ChevFy/RobotCarArduino/Report Robot Car.pdf

## Report

# Robot Car Contest

### contributer

นายนันทพงศ์ พงศธ์ ำ | รงศกั ดิ์ | รหสั นักศกึษา 67011475
นายตณิ ณ์ | สงู เมฆ | รหสั นักศกึษา 67011448

### Introduction to Computer Engineering (ICE) Semester 1 Year 1 | Bachelor of Computer Engineering King Mongkut’s Institute of Technology Ladkrabang, KMITL

### Table of Content

แนวคดิ และหลกั การทำ | งานของ Robot Car | 2
การออกแบบ Hardware ของ Robot Car | 3
Circuit Diagram ของ Robot Car | 5
การออกแบบ Software Design ของ Robot Car | 6
Source Code ของ Robot Car | 10

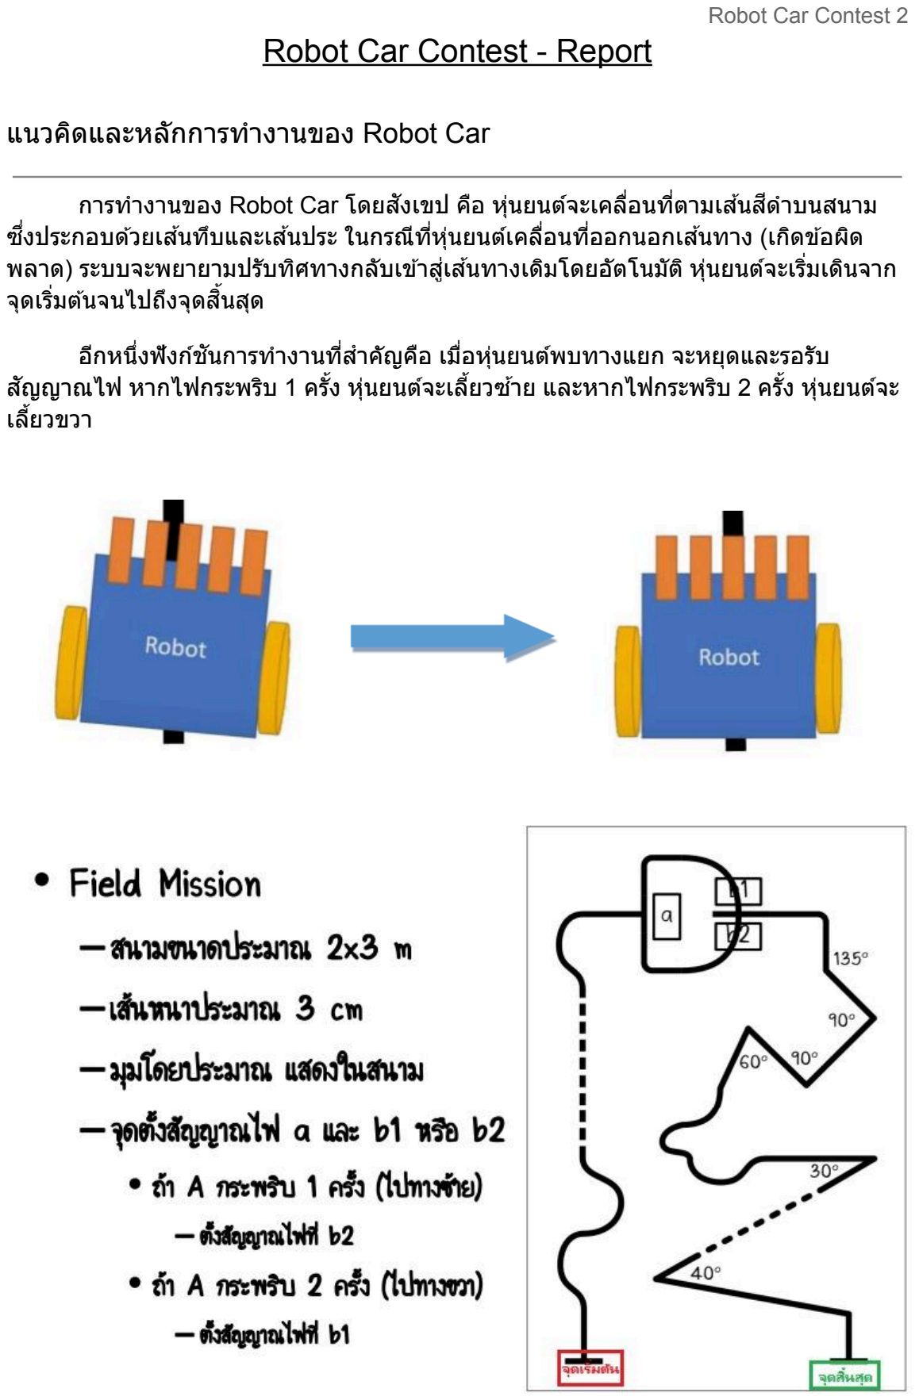
[picture p1: page 2]

Robot Car Contest 2

### Robot Car Contest - Report

แนวคดิ และหลกั การทำ | งานของ Robot Car
การทำ | งานของ Robot Car โดยสงเขป ั | คอื หนุ่ ยนตจะ์ เคลอนท ื่ | ตาม ี่ | เสน้ สดีำ | บนสนาม
ซงึ่ | ประกอบดวย้ เสน้ ทบึ และเสน้ประ ในกรณีทหี่ | นุ่ ยนตเคล ์ | อนท ื่ | ออก ี่ | นอกเสนทาง ้ | (เกดิขอ้ผดิ
พลาด) ระบบจะพยายามปรับทศทาง ิ | กลบั เขา้สเสู่ นทาง ้ | เดมิ โดยอตโนม ั | ตั ิหนุ่ ยนตจะ์ เรมิ่ | เดนิ จาก
จดุ เรมิ่ | ตน้ จนไปถงึจดุ สนสิ้ | ดุ
อกีหนงึ่ | ฟังกช์ นั การทำ | งานทสี่ | ำ | คญั คอื เมอื่ | หนุ่ ยนตพบ์ ทางแยก จะหยดุ และรอรับ
สญญาณ ั | ไฟ หากไฟกระพรบิ 1 ครัง้ | หนุ่ ยนตจะ์ เลยวี้ | ซาย้ และหากไฟกระพรบิ 2 ครัง้ | หนุ่ ยนตจะ์
เลยวี้ | ขวา

การออกแบบ Hardware ของ Robot Car

ในการออกแบบตวั Robot ไดท้ ำ | การจัดวางอปกรณ ุ | ต์ างๆ ่ | ใหเหมาะสม ้ | ไดแก้ ่ บอรด์
Arduino UNO, Ultrasonic Sensor, IR Sensor (TCRT5000), LDR Sensor, L298N Dual
Motor Controllerและรางถาน่ เพอให ื่ | เก้ ดิความสมดลุ

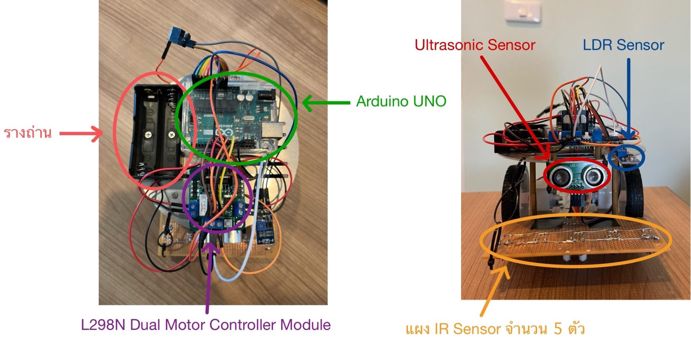
[picture p2: figure]

โดยอปกรณ ุ | ท์ ใชี่ | ม้ดี งนั ี้
ลำ ดบั | ชอื่ อปุ กรณ์ | จำ นวนชนิ้
1 | Robot car | 1
2 | Arduino UNO R3 | 1
3 | Ultrasonic Sensor | 1
4 | LDR Sensor | 1
5 | IR Sensor | 5
6 | ตวัตา้นทาน 220 โอหม์ | 5
7 | ตวัตา้นทาน 10000 โอหม์ | 5
8 | บอรด์ ไขป่ ลา | 1
9 | Pin header | 7
10 | 8 Pin Female Header PCB Connectors | 1

ลำ ดบั | ชอื่ อปุ กรณ์ | จำ นวนชนิ้
11 | L298N Dual Motor Controller Module | 1
12 | รางถา่ น | 1
13 | ถา่ น | 2
14 | DC Motor | 2
15 | Male to Male Cable Jumper | 7
16 | Male to Female Cable Jumper | 20

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
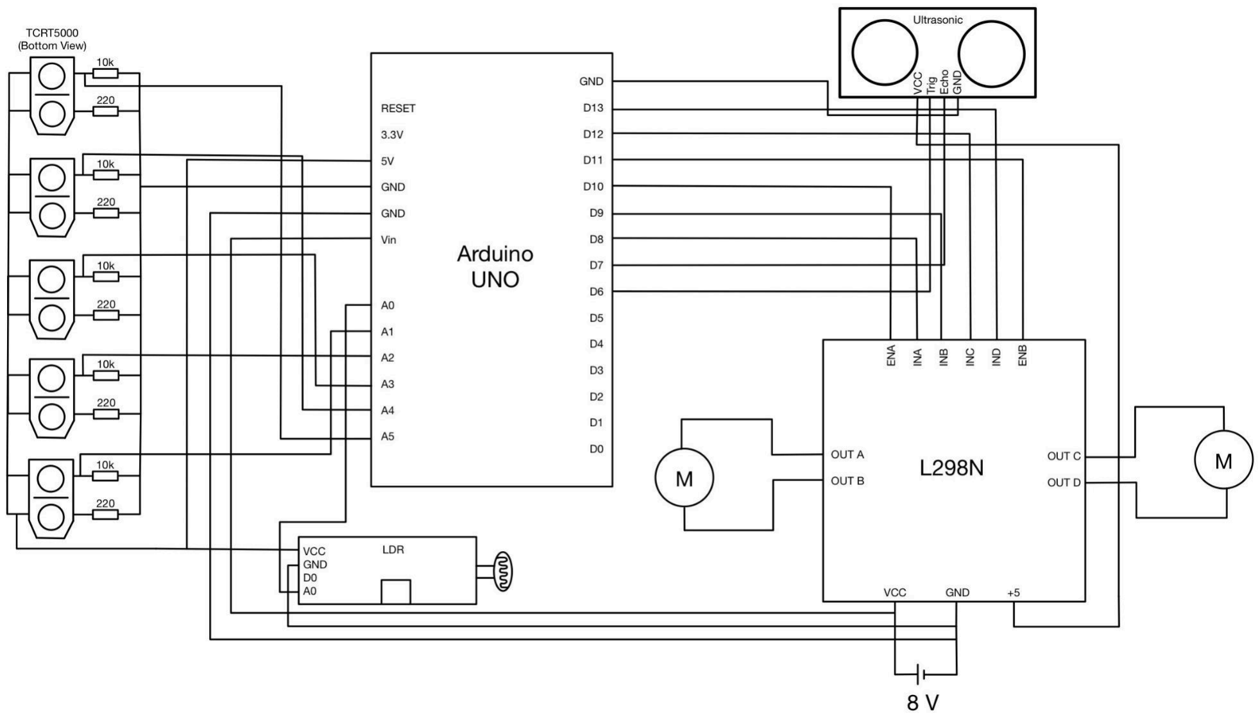
[picture p3: figure]

การออกแบบ Software Design ของ Robot Car

- กลไกการเดนิตามเสน้
ใช ้IR Sensor ทงหมด ั้ | 5 ตวั ในการอาน่ ขอม้ ลู เสน้บนสนาม ณ ขณะเวลา หนงึ่ | ๆ
โดยคา่ เซน็ เซอรท์ อี่ | าน่ เสน้ สดีำ | ไดจะ้ แตกตาง่ กนั เนองจาก ื่ | IR Sensor แตละ ่ ตวัมประส ี | ทธิ ภาพ ิ
แตกตาง่ กนั โดยเรยงี จากซาย้ ไป ขวา ดงัภาพ
IR sensor 1 < 600 จะพบเสน้ดำ
IR sensor 2 < 650 จะพบเสน้ดำ IR sensor 3 < 800 จะพบเสน้ดำ IR sensor 4 < 600 จะพบเสน้ดำ IR sensor 5 < 650 จะพบเสน้ดำ

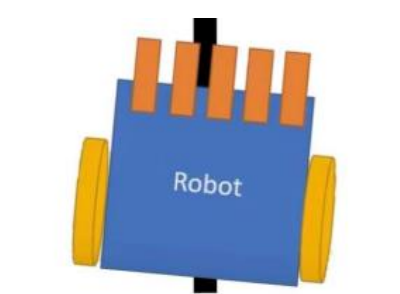
[picture p4: figure]

เพอให ื่ | ง้าย่ ตอ่ ความเขาใจ ้ ไดสะดวก ้ | แทนเลข 1 เมอื่ | เซนเซอร ็ | ์เมอื่ | พบ เสน้ดำ
แทนเลข 0 เมอื่ | เซนเซอร ็ | ์ไมพบ่ | เสน้ดำ
โดยสามารถอธบาย ิ | พฤตกรรม ิ | การเดนเส ิ | น้ โดยทวไป ั่ | ของ Robot car ไดตาม ้ | ตารางนี้
IR SENSOR (จาก ซาย้ ไป ขวา) | พฤตกรรม ิ ของ Robot Car
0 0 1 0 0 | เดนิ ตรง
0 0 1 1 0 | เอยงี ขวาเล็กนอย้
0 1 1 0 0 | เอยงี ซาย้ เล็กนอย้
0 0 0 1 1 | เอยงี ขวา
1 1 0 0 0 | เอยงี ซาย้
0 0 1 1 1 | พบโคง้หกั ศอกทางขวา
1 1 1 0 0 | พบโคง้หกั ศอกทางซาย้
1 0 1 1 1 | พบโคง้หกั มมุ ทางขวา
1 1 1 0 1 | พบโคง้หกั มมุ ทางซาย้
1 1 1 1 1 | พบทางแยก
0 0 0 0 0 | หลดุ ออกจากเสนทาง ้
โดยทพฤต ี่ | กรรม ิ | ของหนุ่ ทแตก ี่ | ตาง่ กนั ในแตละ ่ กรณีจะนำ | ไปสการ ู่ | ตดสั นใจ ิ | เดนิ ทแตก ี่ | ตาง่ กนั
เชน่ หาก หนุ่ อยในู่ สถานะเดนิ ตรงตามเสน้ กจะ็ พยายามเดนิ ตรงตามเสน้ตอ่ ไป แตหาก ่ | ในกรณีที่
หนุ่ มการ ี | เอยงี ออกจาก เสน้ กจะ็ พยายามเดนิ กลบั เขา้สเสู่ น้

- การควบคมุ ทศทาง ิ | ของ Robot Car
ในการควบคมุ Robot Car จะใช ้DC motor จำ | นวนสองตวั (ซาย้ และขวา) โดยสงั่ | งาน
ผาน่ Motor Driver Module (L298N) โดยหากตองการ ้ | ควบคมุ ให้Robot Car เคลอนท ื่ | ไปี่ | ใน
ทศทาง ิ | ทตี่ | าง่ กนั อาจมหลี กการ ั | ในการสงั่ | งานโดยถา้ตองการ ้ | เลยวี้ | จะใหมอเตอร ้ | ์ขาง้ ใดขาง้
นงหม ึ | นุ ชา้กวา่ มอเตอรอ์ กี ขาง้ นงเพึ | อให ื่ | การ ้ เลยวี้ | มประส ี | ทธิ ภาพ ิ | มากทสี่ | ดุ โดยความเร็วปกตทิ ี่
Robot Car ตงั้ | ไวค้ อื 65
ทศทาง ิ | ความเร็ว DC motor (ซาย้ ) | ความเร็ว DC motor (ขวา) | หมายเหตุ
ตรงไป | 65 | 65
เลยวี้ ขวา แบบเลยวี้ ปกติ | 32.50 | 65
เลยวี้ ซาย้ แบบเลยวี้ ปกติ | 65 | 32.50
เลยวี้ ขวา แบบเลยวี้ เฉียบแหลม | 21.67 | 65
เลยวี้ ซาย้ แบบเลยวี้ เฉียบแหลม | 65 | 21.67
เลยวี้ ขวา แบบเลยวี้ เพมิ่ กำ ลงั | 21.67 | 75
เลยวี้ ซาย้ แบบเลยวี้ เพมิ่ กำ ลงั | 75 | 21.67
หมนุ ซาย้ | 65 | 65 | มอเตอรขวา ์ หมนุ ไปขาง้ หนา้ มอเตอรซ์ าย้ หมนุ ไปขาง้ หลงั
หมนุ ขวา | 65 | 65 | มอเตอรซ์ าย้ หมนุ ไปขาง้ หนา้ มอเตอรขวา ์ หมนุ ไปขาง้ หลงั
หยดุ | 0 | 0
ถอยหลงั | 65 | 65 | มอเตอรท์ งั้ คู่ หมนุ ถอยหลงั
โดยในการสงั่ | งาน ไดสร้ าง้ ฟังกช์ นั การเลยวี้ | แตละ ่ แบบไว ้เพอื่ | การสงั่ | งาน
ซงึ่ | จะไดลง้ รายละเอยดี ตอ่ ไปในการอธบาย ิ | Source Code

- Algorithm ในการจดการ ั | กบั เสน้ ประ
เนองจาก ื่ | ในสนามแขง่ มเสี น้ ทเปี่ | ็นลกษณะ ั | ของเสน้ประ ทำ | ใหเม้ อื่ | ตวั Robot Car
เดนทาง ิ | ถงึตำ | แหน่ง เสน้ประดงักลาว่ ทำ | ให ้IR Sensor ทงหมด ั้ | ตรวจจับเป็นสขาว ี | ทำ | ใหเม้ อื่
Robot Car เจอกบั เสน้ประ ตวั Robot Car จะมองวา่ หลดุ ออกนอกเสนทาง ้ | จงึทำ | การถอยหลงั
กลบั จนกลบั มาเจอเสน้ สดีำ | แลว้กจะ็ เดนิหนา้จนเจอสขาว ี | ทงหมด ั้ | อกี แลว้กจะ็ ถอยหลงักลบั มา
เจอสดีำ | อกี วนแบบนไปี้ | เรอยื่ | ๆ ทำ | ให ้Robot Car ไมสามารถ ่ | ผาน่ เสน้ประได ้
จงึแกโดย ้ | การเมอื่ | IR Sensor ทงหมด ั้ | ไมพบ่ เสน้ดำ
1.ใหท้ ำ | การเดนิหนา้ไปเป็นระยะเวลานงึ
2.ถา้เดนิ ไปแลว้ตรวจพบเสน้ดำ | ใหเด้ นิ ไปตอ่ แบบปกติ
ถา้หากไมพบ่ ใหท้ ำ | การถอยหลงัจนกวา่ จะพบเสน้ดำ | เพอื่
ใหเข้ า้สเสู่ นทาง ้ | เดมิ
- Algorithm ในการจดการ ั | กบัสญญาณ ั | ไฟ
เมอื่ | Robot Car อาน่ คา่ จาก IR Sensor ไดเป้ ็นสดีำ | ทงหมด ั้ | Robot Car จะ detect ได ้
วา่ ตอนนนี้ | ่าจะตอง้ รอรับสญญาณ ั | ไฟ เมอื่ | สญญาณ ั | ไฟกระพรบิ 1 และ 2 ครัง้ | Robot Car จะเลยวี้
ไปทางซาย้ และขวาตามลำ | ดบั
การตรวจสอบวา่ สญญาณ ั | ไฟกระพรบิ 1 หรอื 2 ครัง้ | จะใช ้LDR Sensor ซงึ่ | ตงั้
OUTPUT ไวเป้ ็น Analog โดยถา้มไฟี เขา้ LDR Sensor จะใหค้ าท่ นี่ | อย้ กวา่ 600

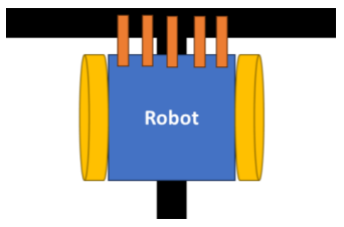
[picture p5: figure]

1.โดยถา้มไฟี เขา้มาจะสราง้ ตวแปร ั | Temp_light = 0 ขนึ้ | มา แลว้ตงั้ | คา่ Temp_light = 1
แลว้รอเป็นระยะเวลา 8 วนาท ิ ี
2.ถา้ระหวาง่ นัน้ | มไฟี เขา้มาอกี รอบ จะตงั้ | Temp_light = 2 พอครบ 8 วนาท ิ ีแลว้ใหท้ ำ
การเลยวี้ | ตามเงอนไข ื่ | ทตี่ | งั้ | ไว ้
3.พอเลยวี้ | แลว้จะใหท้ ำ | การลดกำ | ลงัเครองื่ | ลงเป็นระยะเวลา 15 วนาท ิ ีเพอให ื่ | รถ้ สามารถ
จัดการหนา้รถตวัเองเพอให ื่ | หย้ ดุ ในทางแยกถดั ไปไดอย้ าง่ พอดี
4. และ ในกรณีทหาก ี่ | ไมม่ ไฟี เขา้มา นัน้ | คอื Temp_light = 0 จะใหท้ ำ | การถอยหลงัแทน
เพอให ื่ | รถ้ สามารถเดนิ ไปไดอย้ าง่ ปกติเพอื่ | ป้องกนั ในกรณีเมอื่ | บงเอ ั ญิ เซน็ เซอรท์ งั้ | หมดพบเสน้
ดำ | ทงหมด ั้ | แตไม่ ใช่ ทาง ่ | แยก

- Algorithm การเลยวี้ | เมอื่ | ถงึโคง้หกัมมุ
เมอื่ | เผชญหน ิ | า้กบั โคง้หกั มมุ บอย่ ครัง้ | ที่ | Robot Car จะเกดิปัญหา ในการเลยวี้ | คอื ไม่
สามารถเลยวี้ | ได ้หรอื บางครัง้ | ถอยเขา้ถอยออกจากฟังกช์ นั ทจี่ | ัดการเสน้ประจนไมสามารถ ่ | เดนิ
หนา้ตอ่ ไปได ้จงึคดิ Algorithm ในการจัดการกบั การเลยวี้ | โคง้หกั มมุ ขนึ้

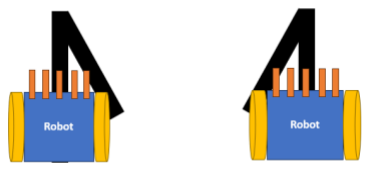
[picture p6: figure]

เรยงี ลำ | ดบั IR Sensor จากซาย้ ไปขวา
โดย จะสงเกต ั | วุ า่ IR Sensor ตวัที่ | 3 และ ตวัที่ | 5 หรอื ตวัที่ | 1 เมอื่ | เป็นกรณีเมอื่ | พบโคง้หกั มมุ
1. จะใหท้ ำ | การใหรถ้ เดนิ ไปขาง้ หนาเป้ ็นระยะเวลา 1 วนาท ิ ีเพอให ื่ | ้IR Sensor พน้ เสน้ดำ
2. เมอื่ | ครบ 1 วนาท ิ ีแลว้ รถจะหมนุ แลว้ หมนุ จนกวา่ IR Sensor ตวัที่ | 1 หรอื ตวัที่ | 5 พบ
เสน้ดำ
3. เมอื่ | พบเสน้ดำ | แลว้ใหรถ้ เดนิ ตามปกติ
ซงึ่ | มอี ตตราการ ั | สำ | เร็จมากกวา่ 90 % ถา้หากไมส่ ำ | เร็จ รถจะทำ | การไปขาง้ หนา้แลว้ถอยหลงักลบั
ตามฟังกช์ นั แบบเดยวี กบั เสน้ประ แกไข้ โดยการตอง้ รเซี ตการ ็ | เดนรถ ิ | ใหม่

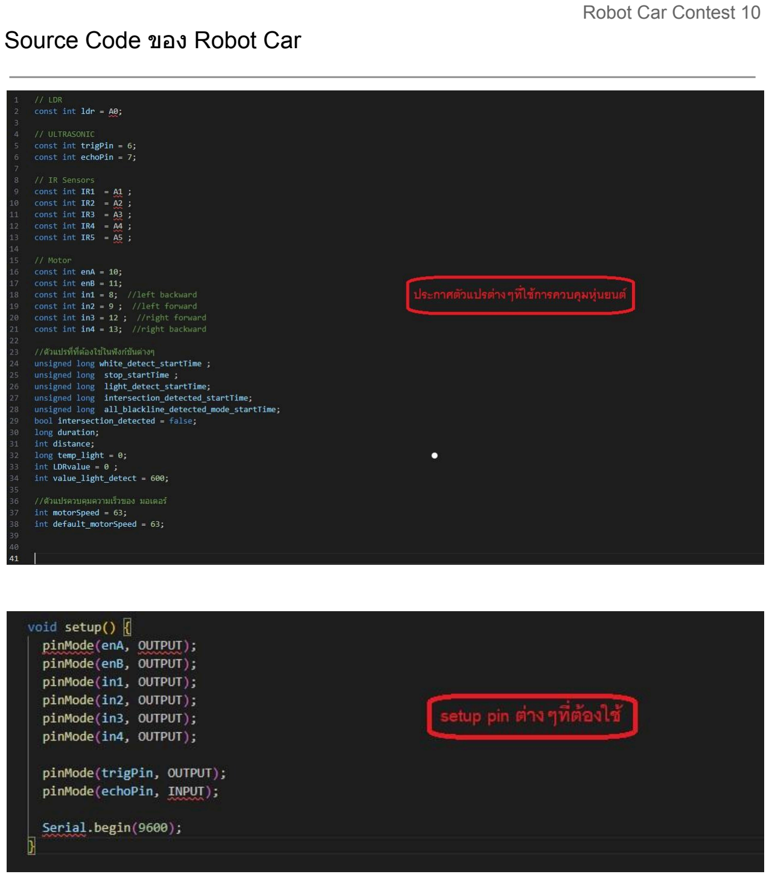
[picture p7: page 10]

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
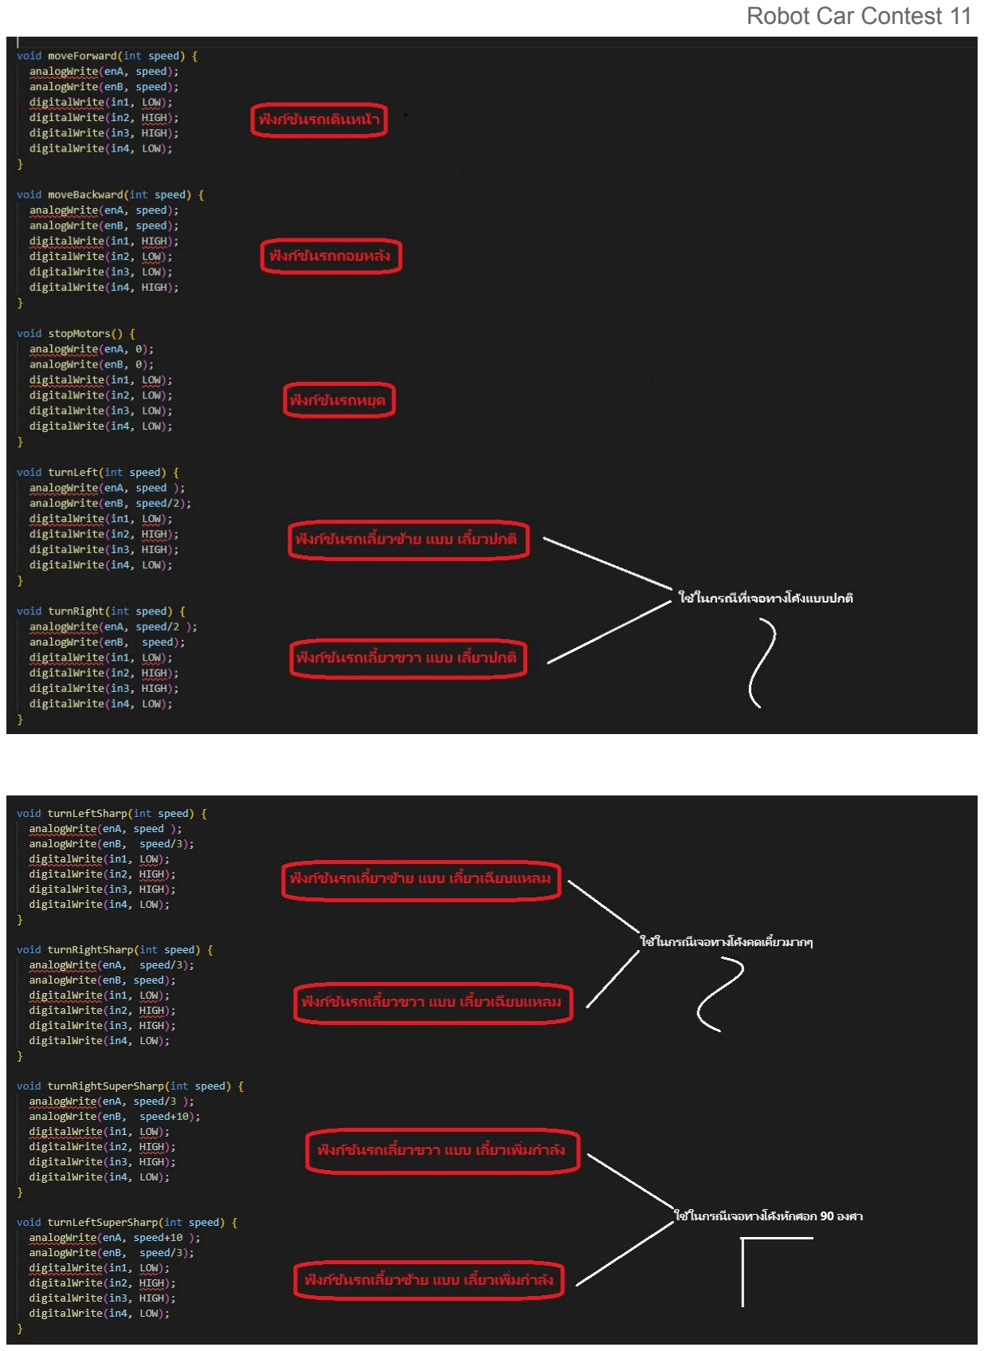
[picture p8: page 11]
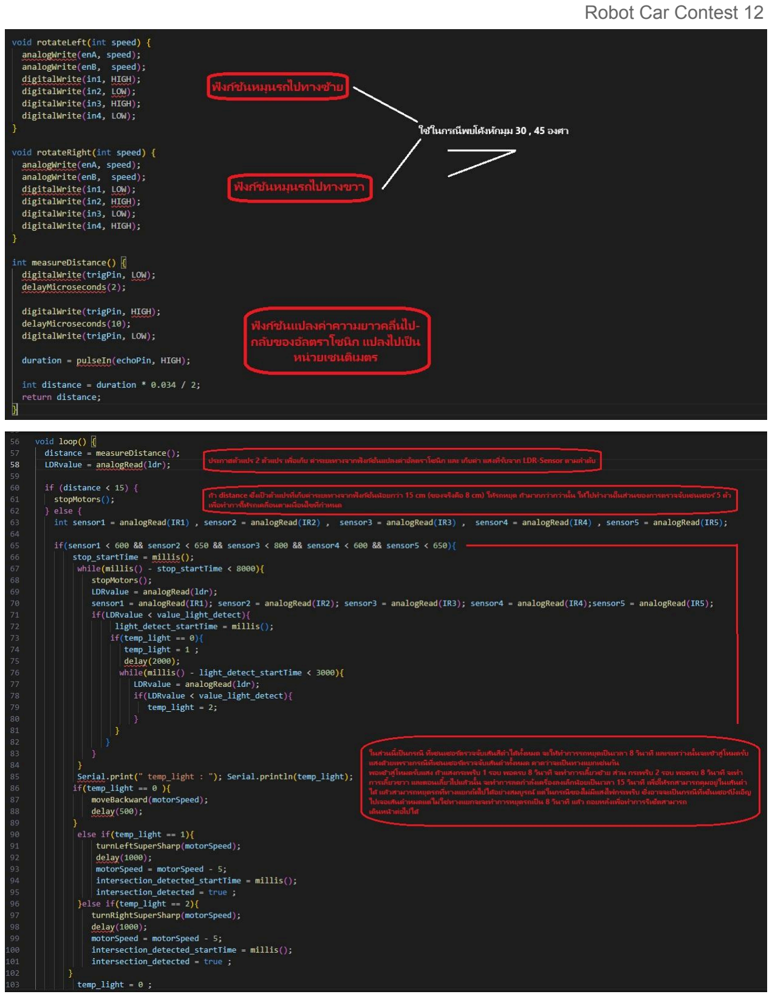
[picture p9: page 12]
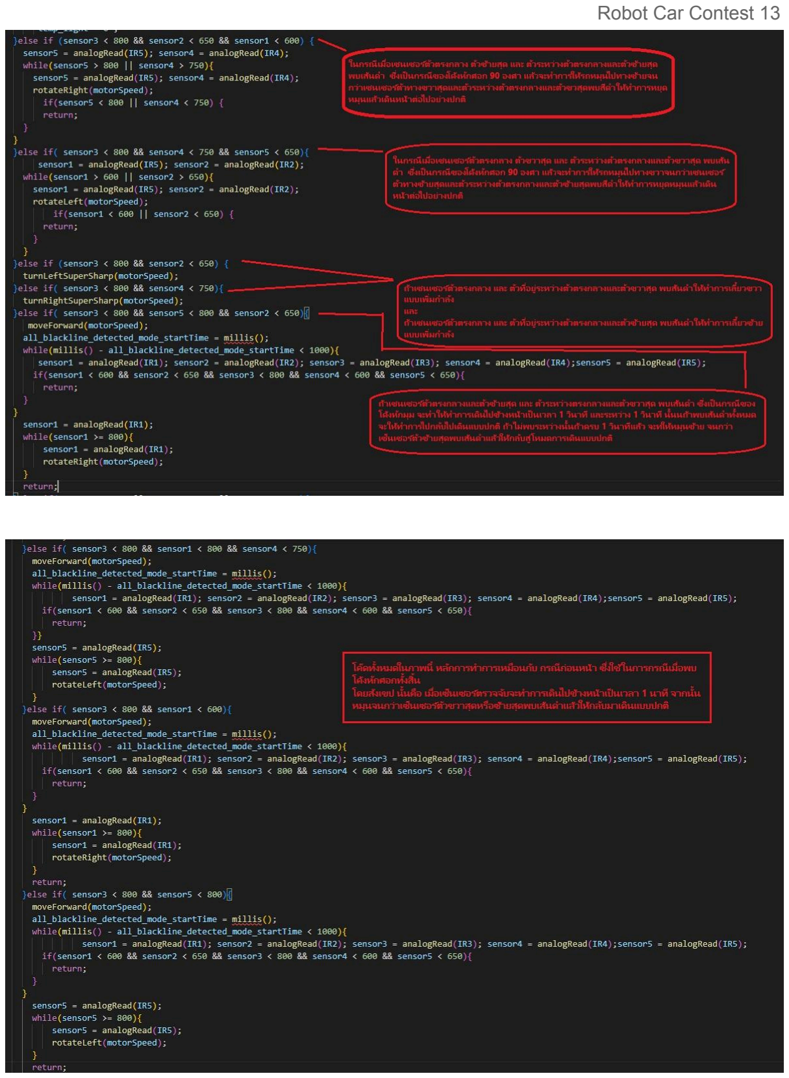
[picture p10: page 13]

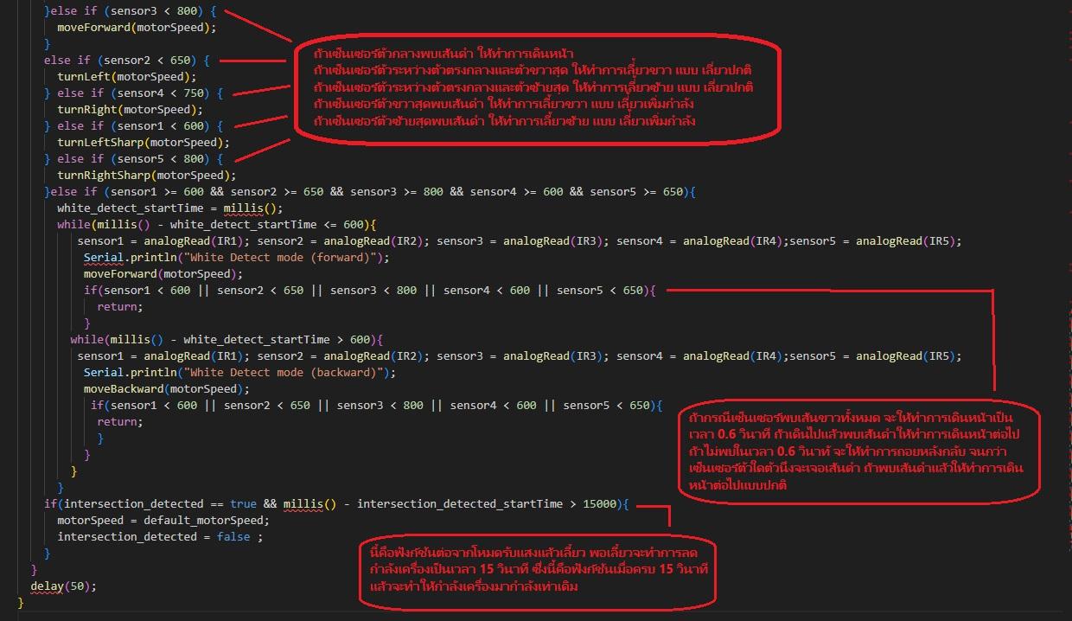
[picture p11: figure]
